Crippiero/turn-trap/documentazione/doc.tex

\documentclass[a4paper,12pt]{article}

% Pacchetti base e lingua
\usepackage[italian]{babel}

% Gestione Font con XeLaTeX
\usepackage{fontspec}
\setsansfont{Helvetica} % NOTA: Se sei su Windows e ti dà errore, scrivi {Arial}
\setmonofont{Consolas}
\renewcommand{\familydefault}{\sfdefault} % Imposta il font sans-serif (Helvetica) come predefinito per il testo

% Altri pacchetti utili
\usepackage{geometry}
\usepackage{graphicx}
\usepackage{amsmath}
\usepackage{hyperref}
\usepackage{caption}
\usepackage{float}
\usepackage{xcolor}
\usepackage{titlesec}
\usepackage{tikz}
\usetikzlibrary{shapes.geometric, arrows.meta, positioning}
\usepackage{listings}
\usepackage{xcolor}
\usepackage[skins,listings,breakable]{tcolorbox} % <--- Pacchetto magico per i riquadri

\geometry{margin=2.5cm}

% https://www.color-hex.com/color-palette/1073443
% definizione colori
\definecolor{titleblue}{RGB}{60, 71, 204}      % titoli principali
\definecolor{subtitlegray}{RGB}{5, 53, 121}   % sottotitoli
\definecolor{subsubtitlegray}{RGB}{29, 108, 167}   % sottosottotitoli

% titoli principali
\titleformat{\section}
  {\Large\bfseries\color{titleblue}}
  {\thesection}{1em}{}

% sottotitoli
\titleformat{\subsection}
  {\large\bfseries\color{subtitlegray}}
  {\thesubsection}{1em}{}

% sottotitoli
\titleformat{\subsubsection}
  {\bfseries\color{subsubtitlegray}}
  {\thesubsubsection}{1em}{}

%caption
\captionsetup[table]{labelfont={color=subsubtitlegray}, font=small}
\captionsetup[figure]{labelfont={color=subsubtitlegray}, font=footnotesize}

%INTERPRETAZIONE CODICE

% 1. Definizione dei colori
% --- COLORI VS CODE LIGHT ---
\definecolor{vsbg}{RGB}{254, 254, 254}        % Sfondo editor (quasi bianco)
\definecolor{backcolour}{RGB}{248, 248, 248}  % Sfondo colonna numeri di riga 
\definecolor{vsgreen}{RGB}{0, 128, 0}         % Commenti (verde scuro)
\definecolor{vslightblue}{RGB}{0, 0, 255}     % Tipi di dato (blu standard)
\definecolor{vsblue}{RGB}{0, 112, 193}        % Variabili (blu VS Code)
\definecolor{vspurple}{RGB}{241, 92, 255}      % Parole chiave (viola scuro)
\definecolor{vsyellow}{RGB}{252, 215, 3}      % Funzioni
\definecolor{vsteal}{RGB}{38, 127, 153}       % Classi (ottanio scuro)
\definecolor{vsorange}{RGB}{163, 21, 21}      % Stringhe (rosso mattone)
% 2. Creazione dell'ambiente "codiceArduino"
\newtcblisting{codiceArduino}[1][]{
    listing only,
    enhanced,                  
    breakable,
    colback=vsbg,
    colframe=darkgray,         
    boxrule=0.5pt,
    arc=2mm,                   
    left=6mm,                  
    underlay={
        \begin{tcbclipinterior}
            % Usato backcolour invece del numberbg non definito
            \fill[backcolour] (interior.south west) rectangle ([xshift=6mm]interior.north west);
        \end{tcbclipinterior}
    },
    #1,
    listing options={
        language=C++,
        basicstyle=\ttfamily\small\color{black}, % <-- Testo base nero per lo sfondo chiaro
        numbers=left,
        numberstyle=\tiny\color{darkgray},
        numbersep=2mm,         
        keywordstyle=\color{vspurple}, % <-- Colori VS Code corretti
        stringstyle=\color{vsorange},
        commentstyle=\color{vsgreen},
        breaklines=true,
        showstringspaces=false,
        % --- GRUPPO 1: Parole chiave principali (Viola) ---
        morekeywords={pinMode, digitalWrite, digitalRead, analogRead, analogWrite, delay, Serial, begin, println, print, HIGH, LOW, INPUT, OUTPUT, setup, loop},
        % --- GRUPPO 2: Variabili e Funzioni personalizzate (Blu) ---
        emph={myMux, strip, myReadings},
        emphstyle=\color{vslightblue},
        % --- GRUPPO 3: Classi (Verde acqua / Teal come in VS Code) ---
        emph={[2]Mux, Adafruit_NeoPixel, MuxControl, h},
        emphstyle={[2]\color{vsteal}},
        % --- GRUPPO 4: Tipi di dato e Macro ---
        emph={[3]uint16_t, int, void, SIZE, DELAY, PIN, NUMPIXELS, NEO_GRB, NEO_KHZ800},
        emphstyle={[3]\color{vsblue}},
        % --- GRUPPO 5: Funzioni (Giallo) ---
        emph={[5]setup, loop, delay, begin, println, print, clear, fullMuxAnalogRead, setPixelColor, show, Color, setupMux},
        emphstyle={[5]\color{vsyellow}},
        % --- SOLO ACCENTI ITALIANI ---
        literate={à}{{\`a}}1 {è}{{\`e}}1 {é}{{\'e}}1 {ì}{{\`i}}1 {ò}{{\`o}}1 {ù}{{\`u}}1 
    }
}

\title{}
\begin{document}

%---------------------------TITLE PAGE---------------------------
\begin{titlepage}
    \centering

    % Spazio iniziale
    \vspace*{0.5cm}

    % Nome competizione
    {\Large \textsc{Campionati Nazionali di Robotica}}\\[0.5cm]
{\large Categoria: \textit{Inventa il tuo gioco}}\\[0.5cm] % <-- Spazio ridotto qui (era 2cm)

%logo squadra
\begin{center}
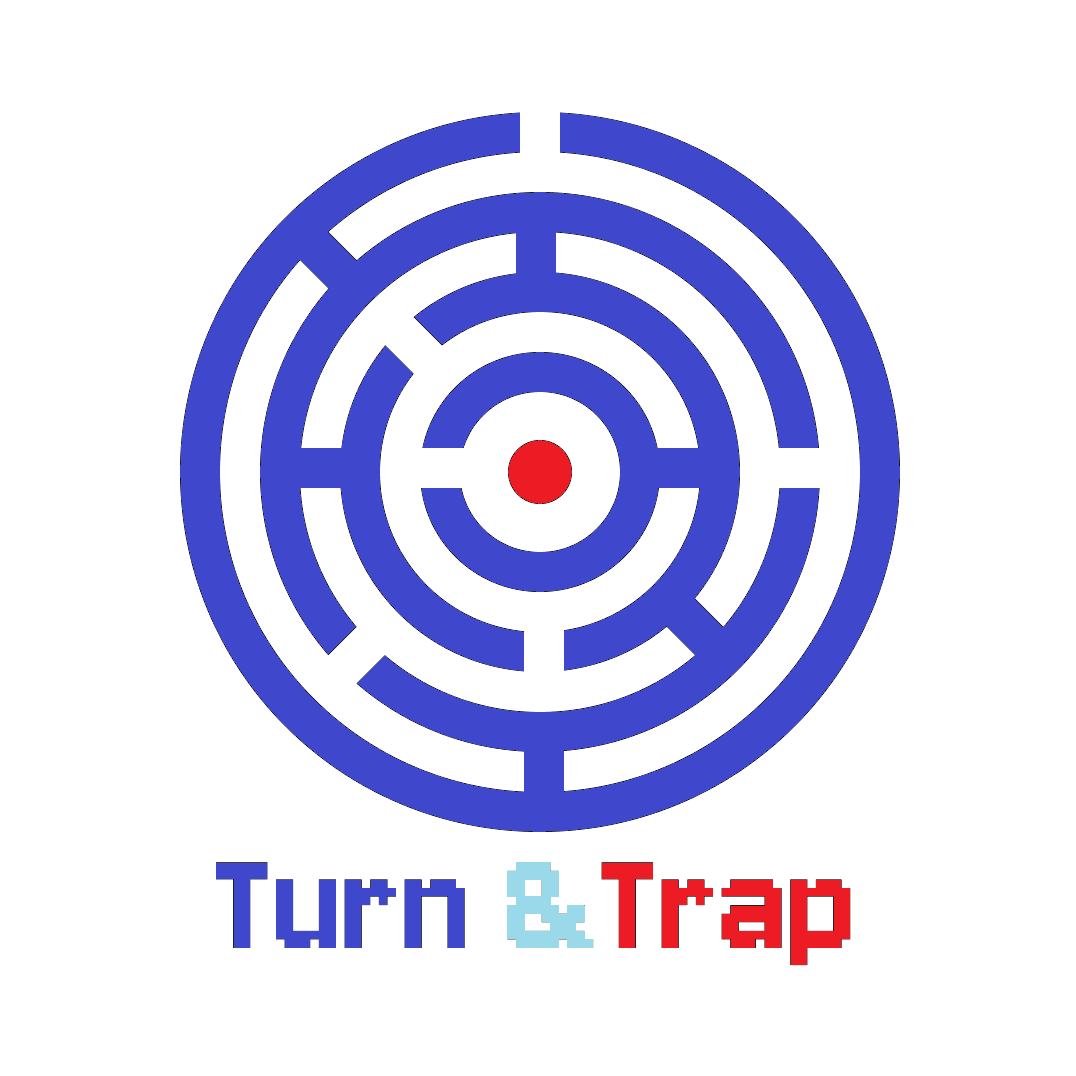
[picture p1: documentazione/img/logo.png]
     % Carica e centra l'immagine senza didascalia
\end{center}

% sottotitolo progetto
{\Large Sei tu a muovere la pedina,\\o è la scacchiera a muovere te?}\\[2cm]

    % Linea decorativa
    \rule{0.8\textwidth}{0.5pt}\\[1.5cm]

    % Team
    {\Large \textbf{Team Elleciesse}}\\[0.5cm]
    {\normalsize
    Aliperti Leonardo\\ 
    Monaco Sofia\\
    Pierozzi Cristian
    }\\[1.5cm]

    % Scuola
    {\normalsize
     Istituto d'Istruzione Superiore "A. Gramsci - J. M. Keynes"\\
    Prato
    }\\[0.5cm]

    % Anno
    {\normalsize Anno scolastico 2025/2026}

    \vfill

\end{titlepage}

%----------------------------------------------------------------

\section{Introduzione}

Siamo gli Elleciesse, un gruppo composto da tre studenti che frequentano il quinto anno presso l’Istituto Gramsci Keynes di Prato. Siamo accomunati dalla passione per la tecnologia, l’innovazione e la voglia di mettersi alla prova con progetti che permettono di unire diverse competenze tecniche, dalla progettazione hardware allo sviluppo software. Nel documento che segue presentiamo il nostro progetto \textit{Turn \& Trap}: un sistema robotico, basato su una scacchiera interattiva, progettato per offrire un’esperienza di gioco unica che combina elementi di fabbricazione digitale, microelettronica e programmazione algoritmica.

Il sistema è costituito da una scacchiera robotica formata da una griglia di celle indipendenti, progettata per integrare sensori di misurazione del campo magnetico e LED indirizzabili. Ogni cella è stata modellata tramite software CAD e realizzata con stampa 3D FDM.

In questo contesto, il robot non è semplicemente un supporto fisico per il gioco, ma un sistema interattivo in grado di rilevare le azioni dei giocatori ed elaborarle tramite un microcontrollore. La scacchiera genera infatti labirinti procedurali che i giocatori devono risolvere spostandosi tra le caselle illuminate per raggiungere il centro, mentre il sistema monitora continuamente la posizione delle pedine e aggiorna lo stato della griglia.

\begin{figure}[H]               % [h] suggerisce a LaTeX di metterla "qui" (here)
    \centering                  % Centra l'immagine nella pagina
    
    \caption{Prototipo della schacchiera 5x5 in fase di realizzazione.} % La didascalia
    \label{fig:addressableLed}     % Un'etichetta per citare l'immagine nel testo
\end{figure}

\section{Le regole del gioco}
Il gioco è pensato per 2-4 giocatori e si sviluppa su una scacchiera composta da 121 celle (11×11). Ogni giocatore inizia posizionando la propria pedina su uno dei 4 angoli.
Per muoversi i giocatori devono seguire un percorso delineato da caselle di colore rosso che fungono da "muri", generate dinamicamente dal sistema. Ogni giocatore può effettuare uno spostamento di una casella per turno. Inoltre durante il gioco verranno generate casualmente delle caselle gialle ad indicare un evento speciale. Una volta posizionata la pedina su una di queste caselle, essa cambierà il proprio colore: verde per indicare un bonus, come ottenere un turno extra oppure far saltare il turno al giocatore successivo, viola per indicare un malus, come essere obbligati a saltare un turno o essere spostati al bordo della scaccchiera. Il sistema monitora in tempo reale la posizione delle pedine e rigenera il percorso quando l'ultimo giocatore dichiara la fine del suo turno attraverso un apposito pulsante. Vince chi raggiunge per primo la casella
centrale di colore blu, decretando la fine del gioco.

\section{Sviluppo del progetto}

\subsection{Descrizione fisica del robot}
Il robot è formato da una scacchiera composta da 121 celle indipendenti, ognuna dotata di un sensore di campo magnetico e di due LED indirizzabili. Abbiamo scelto di suddividire la stampa della scacchiera in 4 sezioni unite tra loro tramite incastri, in modo da facilitare la realizzazione e l’assemblaggio. 
Ogni cella ha dimensione 28x28mm e altezza 10mm, per poter contenere il sensore e i led. In ogni casella, sul fondo, sono presenti due fori per il passaggio dei cavi di alimentazione e il segnale dei sensori, che vengono convogliati verso i multiplexer e successivamente al microcontrollore. I cavi del segnale dei led, invece, percorrono una serpentina lungo tutte le caselle, in modo da poter controllare tutti i LED. Sotto alle caselle è presente una struttura di contenimento che ospita i multiplexer e il microcontrollore, come mostrato in figura 2.

\begin{figure}[h]               % [h] suggerisce a LaTeX di metterla "qui" (here)
    \centering                  % Centra l'immagine nella pagina
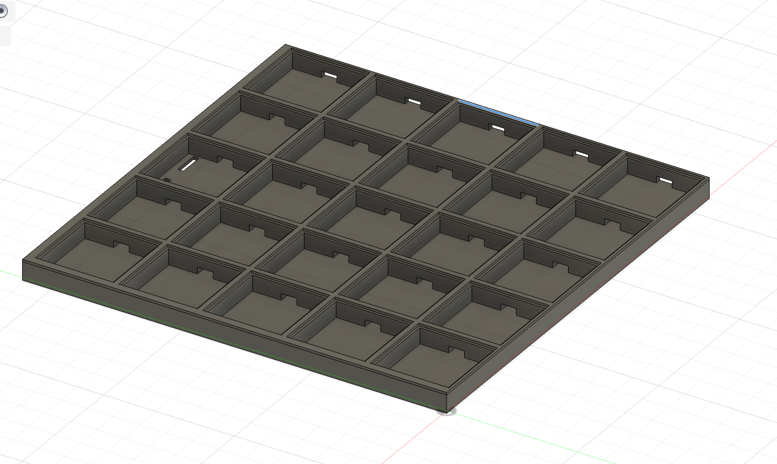
[picture p2: documentazione/img/scacchiera.png]
     % Carica l'immagine e ne imposta la larghezza
    \caption{Modello scacchiera.} % La didascalia
    \label{fig:scacchiera}     % Un'etichetta per citare l'immagine nel testo
\end{figure}
Il design della scacchiera è stato realizzato con software CAD, tenendo conto delle dimensioni dei componenti elettronici e della necessità di un facile assemblaggio. La scacchiera è realizzata in PLA, un materiale plastico comunemente utilizzato nella stampa 3D FDM, scelto per la sua facilità di lavorazione e resistenza sufficiente per l’uso previsto.

\subsection{Hardware}

\subsubsection*{Rilevazione della pedina}
La rilevazione della posizione delle pedine sulla scacchiera avviene tramite sensori di campo magnetico analogici ad effetto Hall (AH3503), posizionati sotto ciascuna casella. Questi sensori sono in grado di rilevare la presenza di un campo magnetico generato da un piccolo magnete inserito alla base delle pedine. Quando una pedina viene collocata sopra una casella, il sensore sottostante rileva la variazione del campo magnetico e restituisce un valore analogico proporzionale alla sua intensità.\\

\begin{figure}[H]               % [h] suggerisce a LaTeX di metterla "qui" (here)
    \centering                  % Centra l'immagine nella pagina
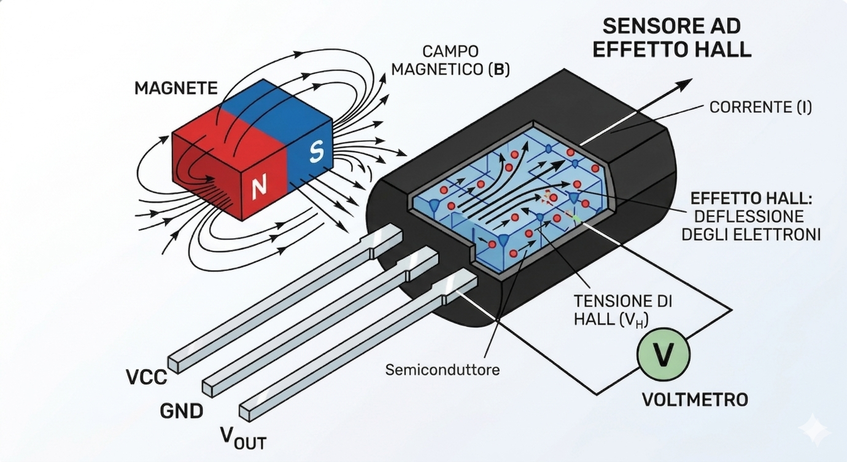
[picture p3: documentazione/img/hall.png]
     % Carica l'immagine e ne imposta la larghezza
    \caption{Funzionamento sensore ad effetto hall.} % La didascalia
    \label{fig:sensoreHall}     % Un'etichetta per citare l'immagine nel testo
\end{figure}

% facciamo vedere che funziona, con le prove che abbiamo fatto finora
Utilizzando un prototipo creato con lo scopo di verificare il funzionamento dei sensori hall e dei multiplexer, abbiamo condotto una serie di test per valutare l’affidabilità del sistema di rilevazione. I risultati ottenuti hanno dimostrato che il sistema è in grado di identificare correttamente la posizione del magnete. Durante i test, abbiamo posizionato una pedina dotata di un magnete sopra un sensore e abbiamo monitorato i valori restituiti. I risultati hanno mostrato che quando la pedina è posizionata correttamente, il sensore restituisce un valore che rientra all’interno dell’intervallo di soglia aspettato tutte le volte, confermando la presenza della pedina sulla casella. Quindi, abbiamo verificato che il sistema è in grado di distinguere tra la presenza e l’assenza della pedina, garantendo un funzionamento affidabile durante le fasi di gioco.

\begin{table}[H]
\centering
\caption{Cinque misurazioni consecutive di dati raccolti durante i test di rilevazione dei sensori Hall. Il magnete è stato posizionato sopra al terzo sensore (sr2).}
\begin{footnotesize}
  \setlength{\tabcolsep}{14pt}
\begin{tabular}{|c|c|c|c|c|c|c|c|c|c|}
\hline
\textbf{sr0} & \textbf{sr1} & \textbf{sr2} & \textbf{sr3} & \textbf{sr4} & \textbf{sr5} & \textbf{sr6} & \textbf{sr7} & \textbf{sr8} & \textbf{sr9} \\ \hline
452 & 442 & \textbf{633} & 446 & 433 & 449 & 444 & 433 & 448 & 443\\ \hline
450 & 440 & \textbf{633} & 446 & 431 & 448 & 442 & 432 & 445 & 441 \\ \hline
455 & 447 & \textbf{641} & 451 & 436 & 452 & 447 & 437 & 450 & 446 \\ \hline
460 & 456 & \textbf{598} & 471 & 442 & 457 & 451 & 442 & 455 & 451\\ \hline
461 & 455 & \textbf{602} & 471 & 441 & 457 & 451 & 442 & 455 & 450\\ \hline
\end{tabular}
\end{footnotesize}
\end{table}

\subsubsection*{Acquisizione dei segnali}
Poiché la scacchiera è composta da 121 caselle, è necessario leggere un numero molto elevato di segnali provenienti dai sensori. Tuttavia, il microcontrollore ATmega328P dispone di un numero limitato di pin di ingresso/uscita (GPIO) e di ingressi analogici.

\subsubsection*{Multiplexing dei sensori}
Per ovviare a questa limitazione hardware abbiamo deciso di utilizzare dei multiplexer analogici (ad esempio 74HC4067), che permettono di convogliare più segnali di ingresso su un singolo canale di lettura del microcontrollore.
Per selezionare il canale desiderato il microcontrollore invia un segnale in codice binario al multiplexer tramite 4 pin digitali, in questo modo è possibile leggere il valore in ingresso tramite un solo pin analogico. Tale sistema permette di interrogare sequenzialmente tutti i sensori, pur utilizzando un numero ridotto di pin.

\begin{figure}[h]               % [h] suggerisce a LaTeX di metterla "qui" (here)
    \centering                  % Centra l'immagine nella pagina
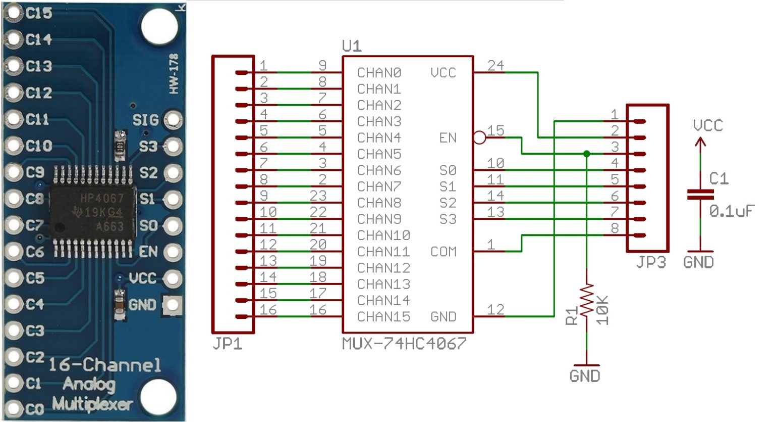
[picture p4: documentazione/img/74HC4067.jpg]
     % Carica l'immagine e ne imposta la larghezza
    \caption{Multiplexer analogico 74HC4067 da noi utilizzato.} % La didascalia
    \label{fig:CD74HC4067}     % Un'etichetta per citare l'immagine nel testo
\end{figure}

\subsubsection*{Addressable LED}
Per la comunicazione visiva con i giocatori, ogni casella della scacchiera è dotata di due LED indirizzabili (WS2812B), che consentono di illuminare ogni cella con colori diversi in modo indipendente. Questi LED vengono utilizzati per evidenziare i percorsi da seguire, le caselle speciali e il centro, contribuendo a creare un’esperienza di gioco coinvolgente e dinamica.

\subsection{Software}

\subsubsection*{Software di controllo}
Il software di controllo del sistema sarà sviluppato in C++, utilizzando l’ambiente di sviluppo tipicamente impiegato per i progetti basati su microcontrollore Arduino. In particolare, il sistema è progettato per funzionare su una scheda Arduino Uno, basata sul microcontrollore ATmega328P.

\subsubsection*{Libreria software MuxControl}
Per semplificare la gestione dei multiplexer abbiamo sviluppato una libreria software dedicata, resa disponibile come progetto open source e pubblicata nel registro ufficiale delle librerie Arduino. Questa libreria fornisce un’interfaccia ad alto livello per selezionare i canali del multiplexer e leggere i valori provenienti dai sensori in modo semplice e strutturato. Esistono, infatti, due funzioni principali: la prima permette di leggere un singolo canale del multiplexer, specificando il numero del canale desiderato, mentre la seconda consente di effettuare una lettura completa di tutti i canali, restituendo i valori in un vettore. Questa funzionalità è particolarmente utile per acquisire rapidamente lo stato di tutti i sensori durante le fasi di gioco.

\subsubsection*{Controllo led}
I LED indirizzabili WS2812B vengono controllati tramite la libreria Adafruit NeoPixel, che consente, in modo indipendente per ogni led, di impostare colore e intensità luminosa. Questa funzionalità è fondamentale per la dinamica di gioco, poiché permette di evidenziare le caselle attive, i percorsi da seguire e le trappole da evitare.

\begin{figure}[h]               % [h] suggerisce a LaTeX di metterla "qui" (here)
    \centering                  % Centra l'immagine nella pagina
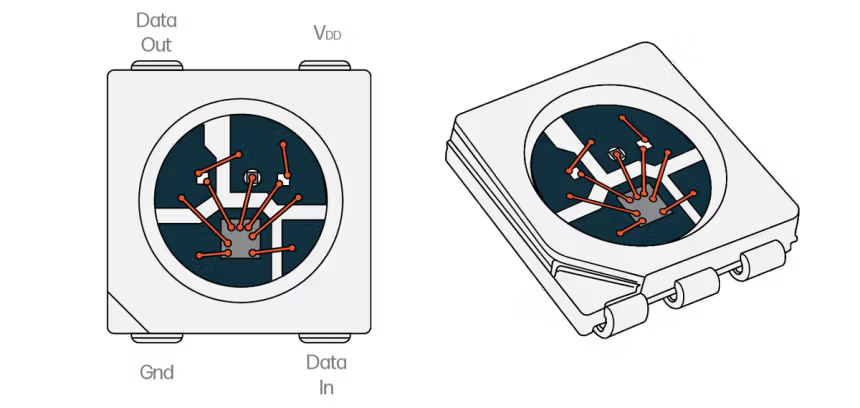
[picture p5: documentazione/img/addressableLed.png]
     % Carica l'immagine e ne imposta la larghezza
    \caption{LED indirizzabili WS2812B.} % La didascalia
    \label{fig:addressableLed}     % Un'etichetta per citare l'immagine nel testo
\end{figure}

\subsubsection*{Generazione del labirinto}
Per generare il labirinto procedurale, il software utilizza l’algoritmo Depth-First Search (DFS) con meccanismo di backtracking per la generazione di labirinti ”perfetti”. L’algoritmo procede in modo esplorativo selezionando casualmente una cella adiacente non ancora visitata e rimuovendo la barriera logica tra di esse; contestualmente, salva le coordinate della cella appena lasciata all'interno di una struttura dati LIFO (Last-In, First-Out), ovvero lo stack. Qualora il sistema raggiunga un ”vicolo cieco” (una cella in cui tutti i nodi adiacenti risultano già visitati), interviene la funzione di backtracking: il sistema estrae sequenzialmente le celle dallo stack (operazione di pop), ripercorrendo a ritroso il percorso fino alla prima cella dotata di rami inesplorati, da cui riprende l'avanzamento.

\begin{figure}[htbp]
\centering
\resizebox{\textwidth}{!}{%
\begin{tikzpicture}[
    >=Stealth,
    node distance=1.2cm and 1.2cm,
    font=\small\sffamily,
    % Definizione degli stili
    base/.style={draw, thick, align=center, inner sep=0.2cm},
    startstop/.style={base, rectangle, rounded corners, fill=black!10, minimum width=1.5cm},
    process/.style={base, rectangle, fill=white, minimum width=2.2cm},
    decision/.style={base, diamond, aspect=1.8, fill=black!5, inner sep=0pt},
    % Stile delle linee
    arrow/.style={->, thick, rounded corners=2pt}
]
    % --- 1. POSIZIONAMENTO DEI NODI ---
    \node[startstop] (start) {\textbf{Inizio}};
    \node[process, right=0.8cm of start] (init) {Inizializza\\Griglia};
    \node[decision, right=0.8cm of init] (dec1) {Celle\\libere?};
    \node[decision, right=1.2cm of dec1] (dec2) {Vicini\\liberi?};
    \node[process, above=0.8cm of dec2] (scava) {Scava e\\Spingi};
    \node[decision, right=1.3cm of dec2] (dec3) {Stack\\vuoto?};
    \node[process, below=0.8cm of dec3] (pop) {Pop\\(Backtrack)};
    \node[startstop, right=1cm of dec3] (fine) {\textbf{Fine}};

    % --- 2. FRECCE PRINCIPALI (Asse Orizzontale) ---
    \draw[arrow] (start) -- (init);
    \draw[arrow] (init) -- (dec1);
    \draw[arrow] (dec1) -- node[above] {\textbf{Sì}} (dec2);
    \draw[arrow] (dec2) -- node[above] {\textbf{No}} (dec3);
    \draw[arrow] (dec3) -- node[above] {\textbf{Sì}} (fine);

    % --- 3. FRECCE DI RITORNO E DIRAMAZIONI ---
    \draw[arrow] (dec1.south) -- ++(0,-2.2) -| node[pos=0.1, above] {\textbf{No}} (fine.south);
    \draw[arrow] (dec2.north) -- node[left] {\textbf{Sì}} (scava.south);
    \draw[arrow] (scava.west) -| (dec1.north);
    \draw[arrow] (dec3.south) -- node[right] {\textbf{No}} (pop.north);
    \draw[arrow] (pop.west) -| (dec2.south);
\end{tikzpicture}%
}
\caption{Diagramma di flusso della generazione del labirinto (DFS con Backtracking).}
\label{fig:dfs_flowchart}
\end{figure}

Questo approccio assicura una copertura completa della griglia e una distribuzione dei percorsi caratterizzata da corridoi lunghi e ramificazioni profonde. La particolarità di questa implementazione è la natura dinamica: il labirinto non è statico, ma viene rigenerato integralmente più volte durante la partita, garantendo però la raggiungibilità degli obiettivi tramite una funzione di ”scavo” assistito. In questo modo, anche se il labirinto viene rigenerato, i giocatori non si troveranno mai in una situazione di stallo, poiché il sistema è progettato per garantire sempre un percorso valido verso il centro della scacchiera.

\subsubsection*{Funzionamento del sistema}
Durante la fase di gioco, il software esegue una scansione periodica di tutti i sensori di campo magnetico ad effetto hall presenti sulla scacchiera. Se il valore misurato rientra all’interno di un intervallo di soglia predefinito, il sistema interpreta tale condizione come la presenza di una pedina nella relativa posizione della scacchiera. L’algoritmo per la generazione del labirinto, quindi, crea un percorso, considerando le posizioni delle pedine, ed esso viene mostrato ai giocatori attraverso i led.

\appendix
\newpage

\section{Codice}
\subsubsection*{Esempio di codice per la lettura dei sensori e controllo dei LED, utilizzato per i test di rilevazione.}

\begin{codiceArduino}[]
#include <MuxControl.h>
#include <Adafruit_NeoPixel.h>

#define PIN 8
#define NUMPIXELS 10
#define SIZE 10
#define DELAY 1000

Adafruit_NeoPixel strip(NUMPIXELS, PIN, NEO_GRB + NEO_KHZ800);
Mux myMux(2000);

uint16_t myReadings[SIZE]; 

void setup() {
  Serial.begin(9600);

  myMux.setupMux(2, 3, 4, 5, A0);

  strip.begin();
  strip.clear();
}

void loop() {
  myMux.fullMuxAnalogRead(SIZE, myReadings);
  int maxIndex = 0, maxValue = 0;
  
  for(int i = 0; i < SIZE; i++) {
    if(myReadings[i] > maxValue) {
      maxValue = myReadings[i]; 
      maxIndex = i;
    }
  }
  
  strip.clear();  
  if(maxValue < 400 || maxValue > 500){
    strip.setPixelColor(maxIndex, strip.Color(255, 0, 0));
  }
  strip.show();
  delay(DELAY);
}
\end{codiceArduino}
\end{document}
