Crippiero/turn-trap/PCB/casella/production/bom.csv

Designator | Footprint | Quantity | Value | LCSC Part #
LED_2, LED | LED_WS2812B_PLCC4_5.0x5.0mm_P3.2mm | 2 | WS2812B
