Crippiero/turn-trap/PCB/casella/Casella.step

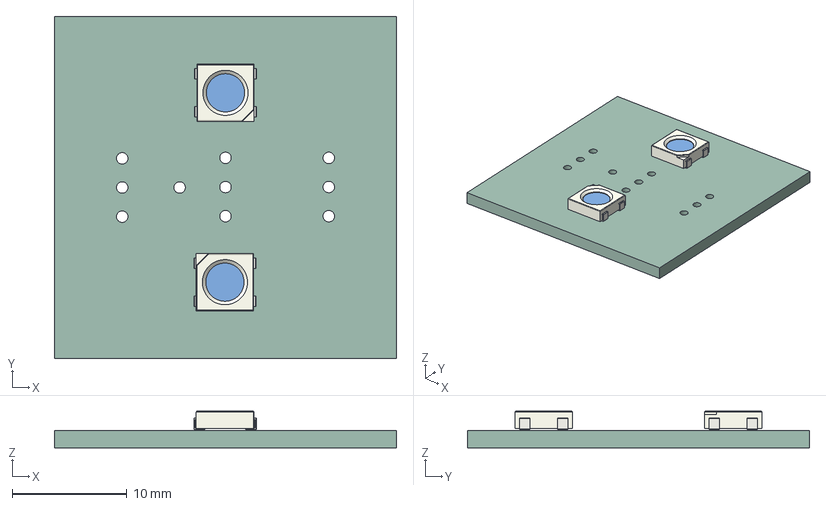
[picture p6: CAD file, 2026-04-16]
PCB/casella/Casella.step
29.8 x 29.8 x 3.20 mm
LED_WS2812B_PLCC4_5.0x5.0mm_P3.2mm x 2
Casella_PCB
