Crippiero/turn-trap/PCB/shield/shield.kicad_pcb

## KiCad design PCB/shield/shield.kicad_pcb (2026-04-10)

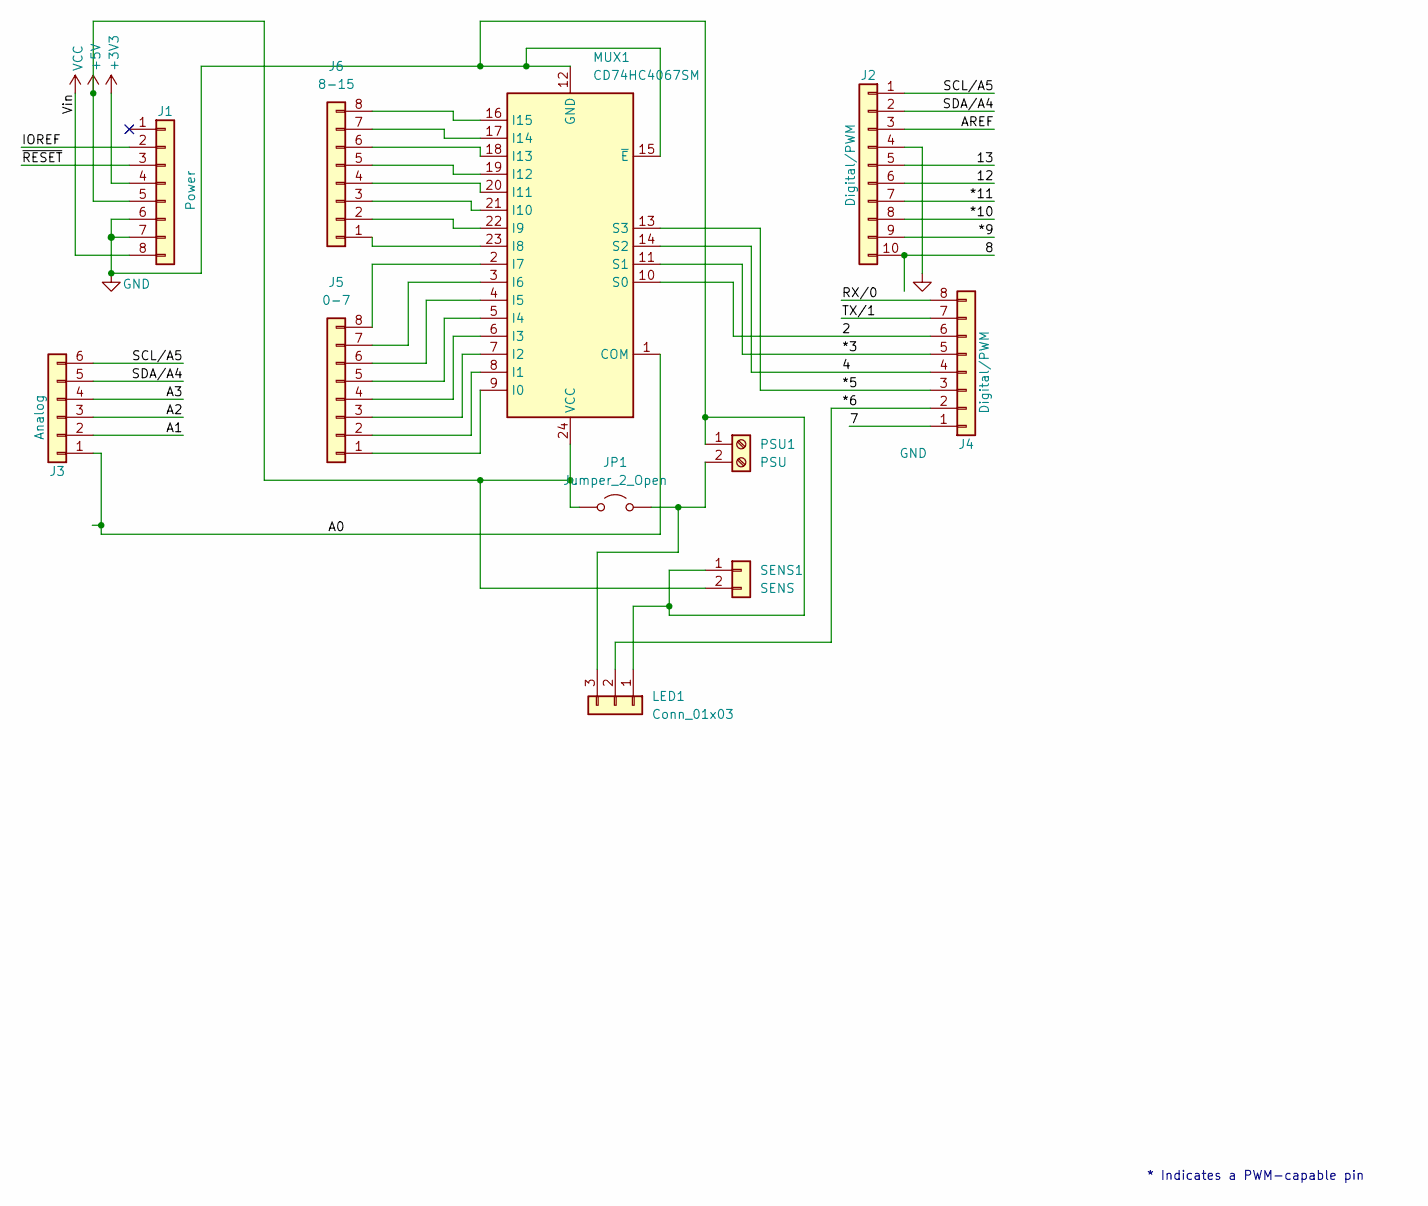
[picture p7: schematic shield.kicad_sch]

Parts:
J1: Power; PinSocket_1x08_P2.54mm_Vertical
J2: Digital/PWM; PinSocket_1x10_P2.54mm_Vertical
J3: Analog; PinSocket_1x06_P2.54mm_Vertical
J4: Digital/PWM; PinSocket_1x08_P2.54mm_Vertical
J5: 0-7; PinSocket_1x08_P2.54mm_Vertical
J6: 8-15; PinSocket_1x08_P2.54mm_Vertical
JP1: Jumper_2_Open; PinHeader_1x02_P2.54mm_Vertical
LED1: Conn_01x03; PinSocket_1x03_P2.54mm_Vertical
MUX1: CD74HC4067SM; SSOP-24_5.3x8.2mm_P0.65mm
PSU1: PSU; TerminalBlock_Phoenix_MKDS-1,5-2_1x02_P5.00mm_Horizontal
SENS1: SENS; PinSocket_1x02_P2.54mm_Vertical

Connections:
+3V3: J1.4
+5V: J1.5, JP1.1 (A), MUX1.24 (VCC), SENS1.2
/2: J4.6, MUX1.10 (S0)
/4: J4.4, MUX1.14 (S2)
/7: J4.1
/8: J2.10
/12: J2.6
/13: J2.5
/*3: J4.5, MUX1.11 (S1)
/*5: J4.3, MUX1.13 (S3)
/*6: J4.2, LED1.2
/*9: J2.9
/*10: J2.8
/*11: J2.7
/A0: J3.1, MUX1.1 (COM)
/A1: J3.2
/A2: J3.3
/A3: J3.4
/AREF: J2.3
/IOREF: J1.2
/RX/0: J4.8
/SCL/A5: J2.1, J3.6
/SDA/A4: J2.2, J3.5
/TX/1: J4.7
/~RESET: J1.3
GND: J1.6, J1.7, J2.4, LED1.1, MUX1.12 (GND), MUX1.15 (~E), PSU1.1, SENS1.1
unnamed: J5.1, MUX1.9 (I0)
unnamed: J5.2, MUX1.8 (I1)
unnamed: J5.3, MUX1.7 (I2)
unnamed: J5.4, MUX1.6 (I3)
unnamed: J5.5, MUX1.5 (I4)
unnamed: J5.6, MUX1.4 (I5)
unnamed: J5.7, MUX1.3 (I6)
unnamed: J5.8, MUX1.2 (I7)
unnamed: J6.1, MUX1.23 (I8)
unnamed: J6.2, MUX1.22 (I9)
unnamed: J6.3, MUX1.21 (I10)
unnamed: J6.4, MUX1.20 (I11)
unnamed: J6.5, MUX1.19 (I12)
unnamed: J6.6, MUX1.18 (I13)
unnamed: J6.7, MUX1.17 (I14)
unnamed: J6.8, MUX1.16 (I15)
unnamed: JP1.2 (B), LED1.3, PSU1.2
VCC: J1.8

Notes on the sheet:
* Indicates a PWM-capable pin

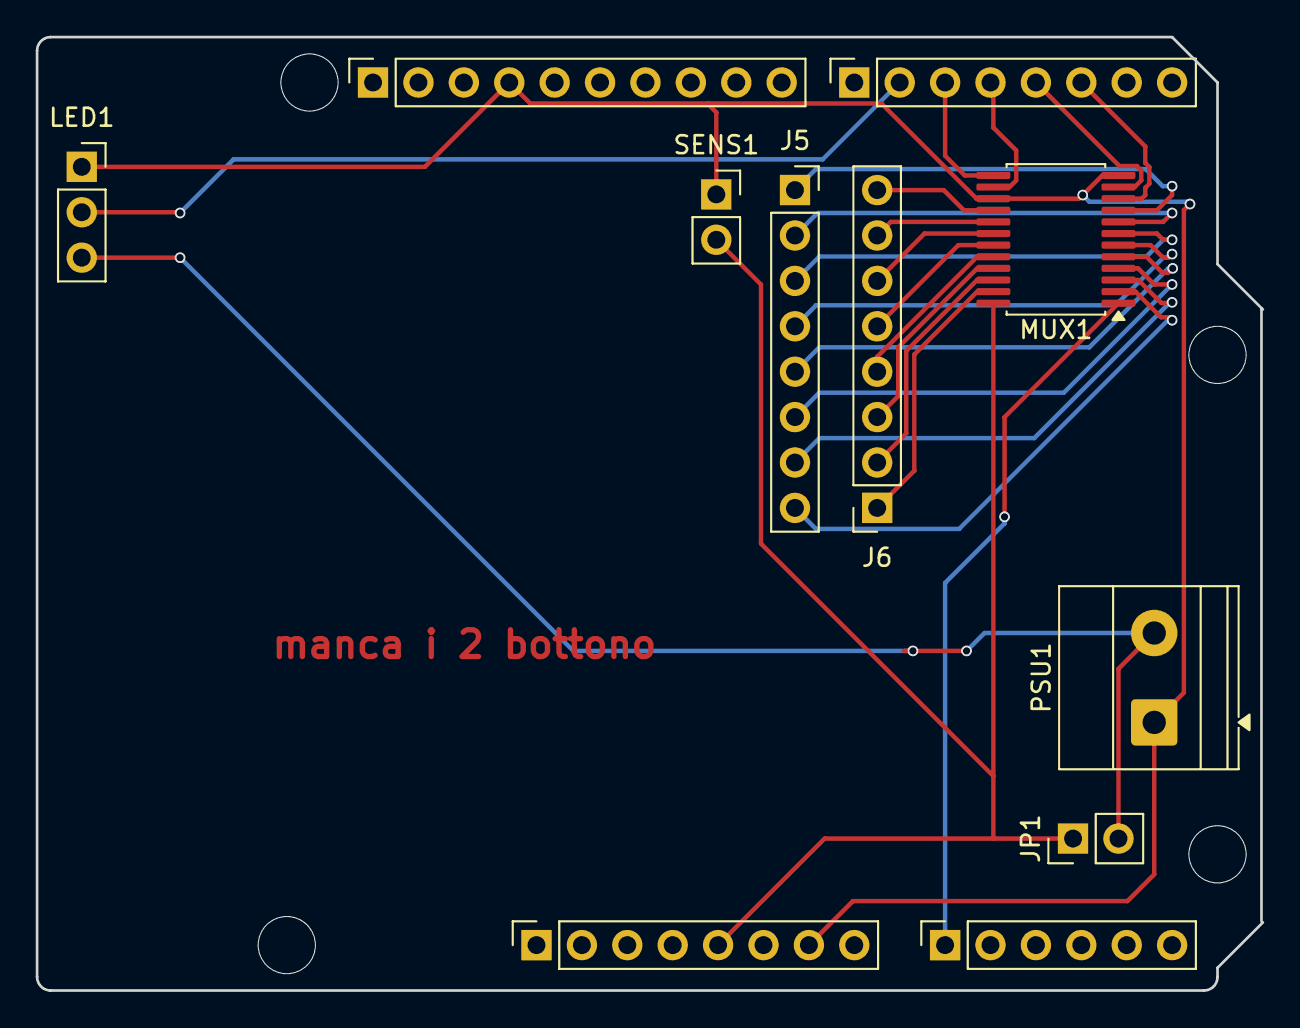
[picture p8: board shield.kicad_pcb from above]

Board: 2 copper layers, 68.6 x 53.3 mm, 15 parts (0 on the bottom side), 27 nets.

Other parts of the board:
MH1, MH2, MH3, MH4: MountingHole_3.2mm
