Crippiero/turn-trap/code/EspWifi-LedDriver/slave.ino

#include <Adafruit_NeoPixel.h>

constexpr uint8_t NUM_BOXES 11
constexpr uint8_t RESOLUTION 2 // LED per ogni casella logica
constexpr uint8_t NUM_LEDS = NUM_BOXES*RESOLUTION; // 11 caselle * 2 LED = 22 LED fisici
constexpr uint8_t NUM_STRIPS 11 // Dal pin 2 al 12

// Creiamo un array per contenere le striscie. 
Adafruit_NeoPixel strips[NUM_STRIPS] = {
  Adafruit_NeoPixel(NUM_LEDS, 2, NEO_GRB + NEO_KHZ800),
  Adafruit_NeoPixel(NUM_LEDS, 3, NEO_GRB + NEO_KHZ800),
  Adafruit_NeoPixel(NUM_LEDS, 4, NEO_GRB + NEO_KHZ800),
  Adafruit_NeoPixel(NUM_LEDS, 5, NEO_GRB + NEO_KHZ800),
  Adafruit_NeoPixel(NUM_LEDS, 6, NEO_GRB + NEO_KHZ800),
  Adafruit_NeoPixel(NUM_LEDS, 7, NEO_GRB + NEO_KHZ800),
  Adafruit_NeoPixel(NUM_LEDS, 8, NEO_GRB + NEO_KHZ800),
  Adafruit_NeoPixel(NUM_LEDS, 9, NEO_GRB + NEO_KHZ800),
  Adafruit_NeoPixel(NUM_LEDS, 10, NEO_GRB + NEO_KHZ800),
  Adafruit_NeoPixel(NUM_LEDS, 11, NEO_GRB + NEO_KHZ800),
  Adafruit_NeoPixel(NUM_LEDS, 12, NEO_GRB + NEO_KHZ800),
};

String packetBuffer = "";

void setup() {
  // Avvia la comunicazione con il Master
  // Assicurati che il TX del Master sia collegato all'RX (Pin 0) di questo Slave
  Serial.begin(38400); 
  
  // Riserva un po' di memoria per evitare frammentazione della RAM
  packetBuffer.reserve(50);

  // Inizializza tutte le strisce
  for(int i = 0; i < NUM_STRIPS; i++) {
    strips[i].begin();
    strips[i].show(); // Assicurati che partano spente
  }
}

void loop() {
  // Leggi i dati in arrivo dal Master
  while (Serial.available()) {
    char c = Serial.read();
    
    if (c == '<') {
      packetBuffer = ""; // Inizio di un nuovo pacchetto, pulisci il buffer
    } 
    else if (c == '>') {
      processCommand(packetBuffer); // Fine del pacchetto, eseguilo!
    } 
    else {
      packetBuffer += c; // Accumula i caratteri
    }
  }
}

// --- LOGICA DI DECODIFICA E DISEGNO ---

void processCommand(String packet) {
  // Suddivide il pacchetto separato da virgole
  char cmdType = packet.charAt(0);

  if (cmdType == 'R') {
    // Ricezione di una riga: R,indiceRiga,caratteri
    int firstComma = packet.indexOf(',');
    int secondComma = packet.indexOf(',', firstComma + 1);
    
    if (firstComma != -1 && secondComma != -1) {
      int rIdx = packet.substring(firstComma + 1, secondComma).toInt();
      String rowData = packet.substring(secondComma + 1);
      
      if (rIdx >= 0 && rIdx < NUM_STRIPS) {
        // --- BLOCCO R (Costruzione riga con Resolution) ---
        for (int logicalX = 0; logicalX < rowData.length(); logicalX++) {
          char cell = rowData.charAt(logicalX);
          uint32_t color = getColorFromChar(cell, rIdx);
          
          // Accende RESOLUTION LED per ogni casella logica
          for (int r = 0; r < RESOLUTION; r++) {
            int targetX = (logicalX * RESOLUTION) + r; 
            
            // Inversione a serpentina: se la riga (rIdx) è dispari, inverte l'indice fisico
            int physicalX = (rIdx % 2 != 0) ? (NUM_LEDS - 1 - targetX) : targetX; 
            
            strips[rIdx].setPixelColor(physicalX, color);
          }
        }
      }
    }
  } 
  else if (cmdType == 'U') {
    // Imprevisto o Evento singolo: U,X,Y,Colore
    int c1 = packet.indexOf(',');
    int c2 = packet.indexOf(',', c1 + 1);
    int c3 = packet.indexOf(',', c2 + 1);
    
    if (c1 != -1 && c2 != -1 && c3 != -1) {
      int x = packet.substring(c1 + 1, c2).toInt();
      int y = packet.substring(c2 + 1, c3).toInt(); // Y corrisponde all'indice della striscia
      char colorCode = packet.charAt(c3 + 1);
      
      // Verifica i limiti logici di X e Y
      if (y >= 0 && y < NUM_STRIPS && x >= 0 && x < (NUM_LEDS / RESOLUTION)) {
        uint32_t color = getColorFromChar(colorCode, y);
        
        // --- BLOCCO U (Singoli pixel con Resolution) ---
        for(int r = 0; r < RESOLUTION; r++) {
          int targetX = (x * RESOLUTION) + r;
          
          // Inversione a serpentina
          int physicalX = (y % 2 != 0) ? (NUM_LEDS - 1 - targetX) : targetX;
          
          strips[y].setPixelColor(physicalX, color);
        }
      }
    }
  } 
  else if (cmdType == 'C') {
    // Comando Clear: Pulisce tutte le strisce
    for(int i = 0; i < NUM_STRIPS; i++) {
      strips[i].clear();
    }
  } 
  else if (cmdType == 'S') {
    // Comando Show: Applica le modifiche fisicamente ai LED
    for(int i = 0; i < NUM_STRIPS; i++) {
      strips[i].show();
    }
  }
}

// --- MAPPATURA COLORI ---

uint32_t getColorFromChar(char c, int stripIndex) {
  // Nota: usiamo strips[stripIndex].Color per generare il formato colore corretto.
  // Puoi modificare i valori (R, G, B) a tuo piacimento.
  
  switch (c) {
    case '#': return strips[stripIndex].Color(255, 0, 0);     // Muro = Rosso
    case 'x': return strips[stripIndex].Color(20, 20, 20);    // Vuoto = Bianco tenue
    case 'E': return strips[stripIndex].Color(20, 20, 20);    // Empty (pulizia imprevisto)
    case 'G': return strips[stripIndex].Color(150, 0, 200);   // Goal = Viola
    case 'U': return strips[stripIndex].Color(255, 255, 0);   // Bonus = Giallo
    case 'B': return strips[stripIndex].Color(255, 255, 0);   // Bonus = Giallo
    case 'M': return strips[stripIndex].Color(255, 128, 0);   // Malus = Arancione
    case 'W': return strips[stripIndex].Color(255, 128, 0);   // Malus = Arancione
    default:  return strips[stripIndex].Color(0, 0, 0);       // Sicurezza = Spento
  }
}
