Crippiero/turn-trap/(commit log)

2026-04-01 Add RGB LED control for multiple strips
2026-04-08 Create switch-labirinto-5x5
2026-04-09 Change Podium coordinates to int8_t and update logic
    Changed data type of x and y in Podium structure from uint8_t to int8_t. Updated initialization in magnetDetection function and adjusted condition in debug print statement.
2026-04-16 Riorganizzazione file
    [Casella.kicad_pcb, Casella.kicad_sch, Casella.step, base.csv, bom.csv, designators.csv, positions.csv]
2026-04-29 modifiche pin
2026-04-29 removed old pin for button
2026-04-29 utilizzo di constexpr per un boot piu veloce
2026-05-01 Add Arduino sketch for NeoPixel control
2026-05-01 Set LED strip brightness to 100
2026-05-01 finie di generateUnprPoint
2026-05-06 if to switch line 256
2026-05-06 aggiunta di nuove funzioni
2026-05-06 Rimosso un duplicato di chiamata della funzione renderNewMaze in riga 455
2026-05-06 stampa su seriale mentre si aspetta per il reset
    [main.ino]
2026-05-06 Creo un punto per salvare unpr. Correzione errori di compilazione dovuti a ";" mancanti. Aggiunto un limite alle prove nella funzione generateUnprPoint per evitare loop infiniti. Modifica di resoluti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
    [main.ino]
2026-05-06 Uso di millis() al posto di delay per non far addormentare l'arduino
2026-05-07 aggiunta di getPixelIndex non ancora implementata
2026-05-07 Aggiornamento printUnpr e inizio di checkUnpr
2026-05-07 implementazione di getPixelIndex in renderNewMaze
2026-05-07 semplificazione di getUnpr con implementazione del doppio turno
2026-05-07 prima versione finita di getUnpr
2026-05-07 correzioni per errori di compilazione
    [main.ino]
2026-05-07 miglioramento di getUnpr
2026-05-07 ulteriore miglioramento di getUnpr
2026-05-07 aggiunta strip.show per visualizzare le modifiche di unpr
2026-05-07 spostamento di unpr dal loop alla funzione processSerialCommands
2026-05-08 creazione di nuovi file per la gestione dei led con un'arduino a parte
2026-05-08 Copia di Esp.ino dalla cartella conEspWifi a EspWifi-LedDriver
2026-05-09 modifica di slave.ino per dividere le strisce
2026-05-09 reintroduzione di resolutuion
2026-05-09 rinominata la funzione isValidinUnpr in inGame
2026-05-09 correzioni di layout
2026-05-09 correzione di getUnpr per gestire il turno bloccato di un giocatore
2026-05-09 modifiche di variabile in slave.ino
2026-05-09 aggiunta di funzioni per comunicare al web cosa sta facendo il master con parole testuali
2026-05-09 implementazione di SendInfoToWeb in ResetCalibration
    [master.ino]
2026-05-09 modalità accesPoint invede di host
2026-05-09 correzione di una funzione fantasma rimasta dopo il cambio del nome
2026-05-09 nuova versione di eso.ino non testata
2026-05-10 creazione di NeopixelFake per non dover riscrivere l'intero codice
2026-05-10 ulteriori modifiche per il miglioramento del sito web
